yahya-tamur/blinds/carrier/pcb/boards/v0.2.0/manufacturing/carrier_v0.2.0_assembly.stl

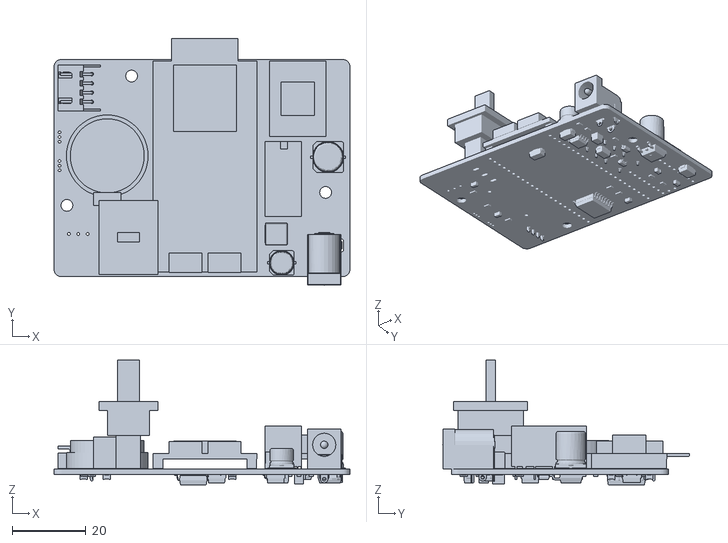
[picture p3: CAD file, 2026-11-02]
carrier/pcb/boards/v0.2.0/manufacturing/carrier_v0.2.0_assembly.stl
80.1 x 66.7 x 33.7
