yahya-tamur/blinds/carrier/pcb/boards/v0.2.0/carrier.kicad_pcb

## KiCad design carrier/pcb/boards/v0.2.0/carrier.kicad_pcb (2026-11-02)

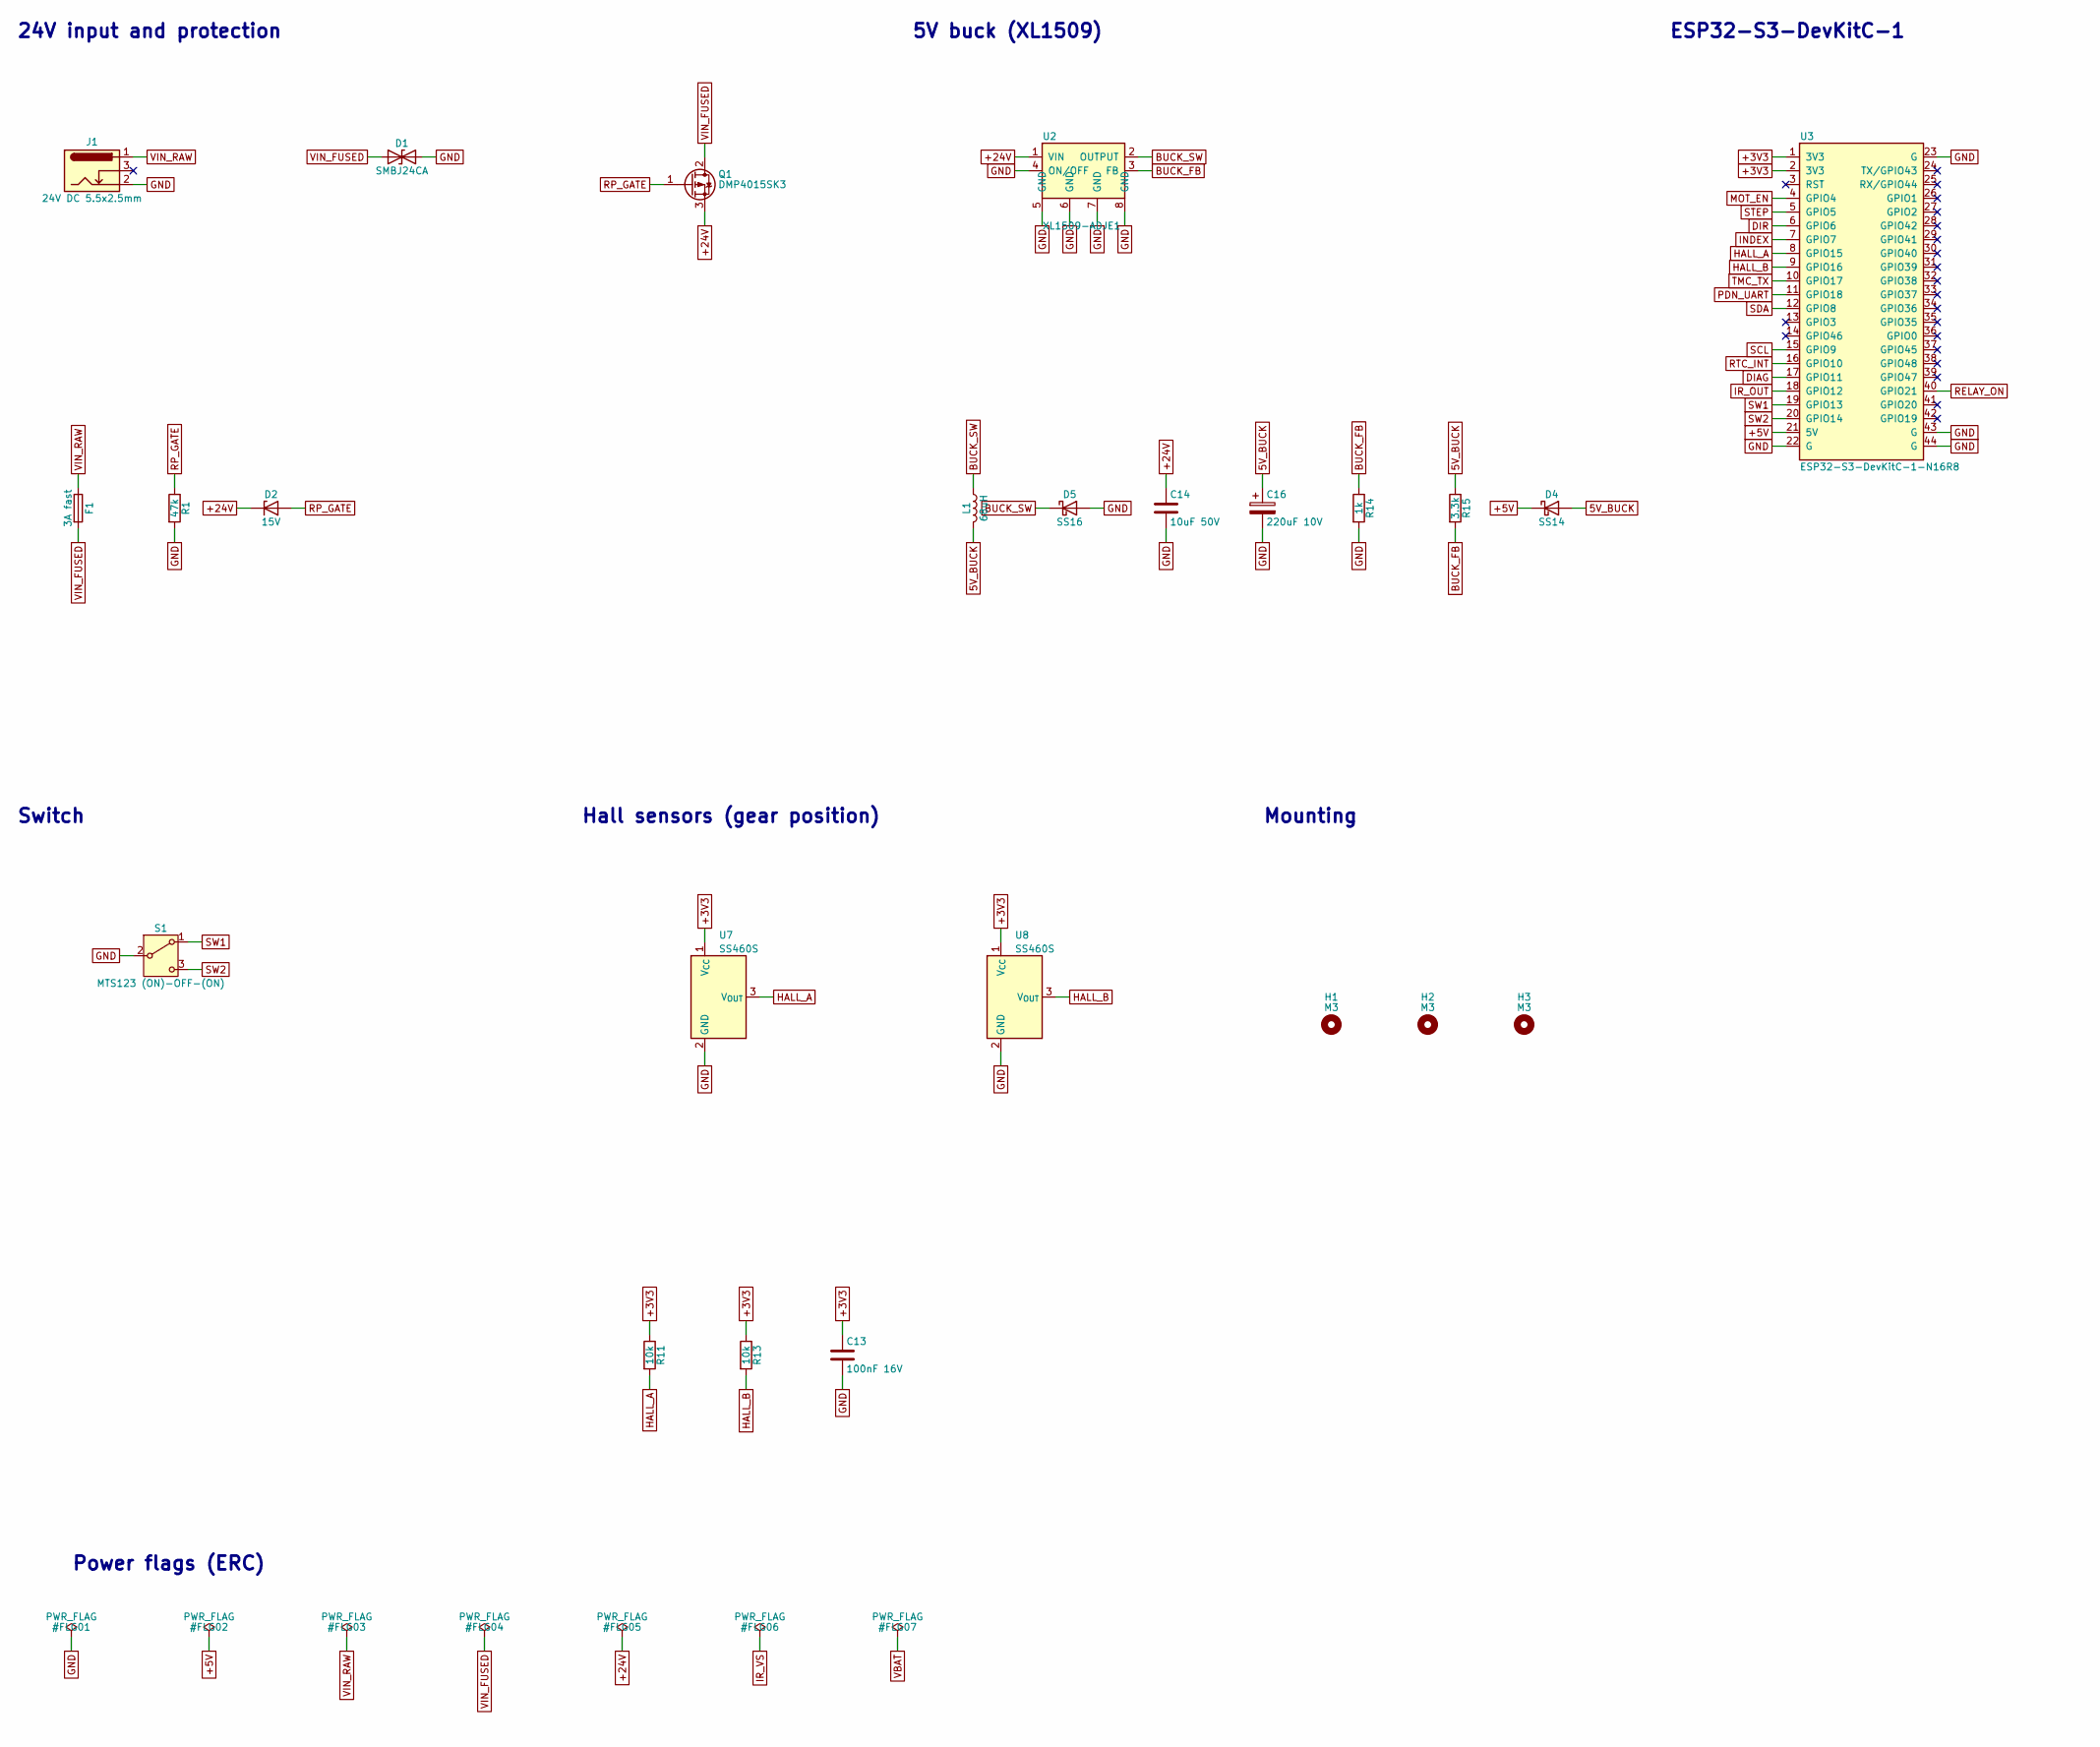
[picture p5: schematic carrier.kicad_sch, ESP32-S3 stepper controller - carrier v0.2.0, part in row 1, column 1]

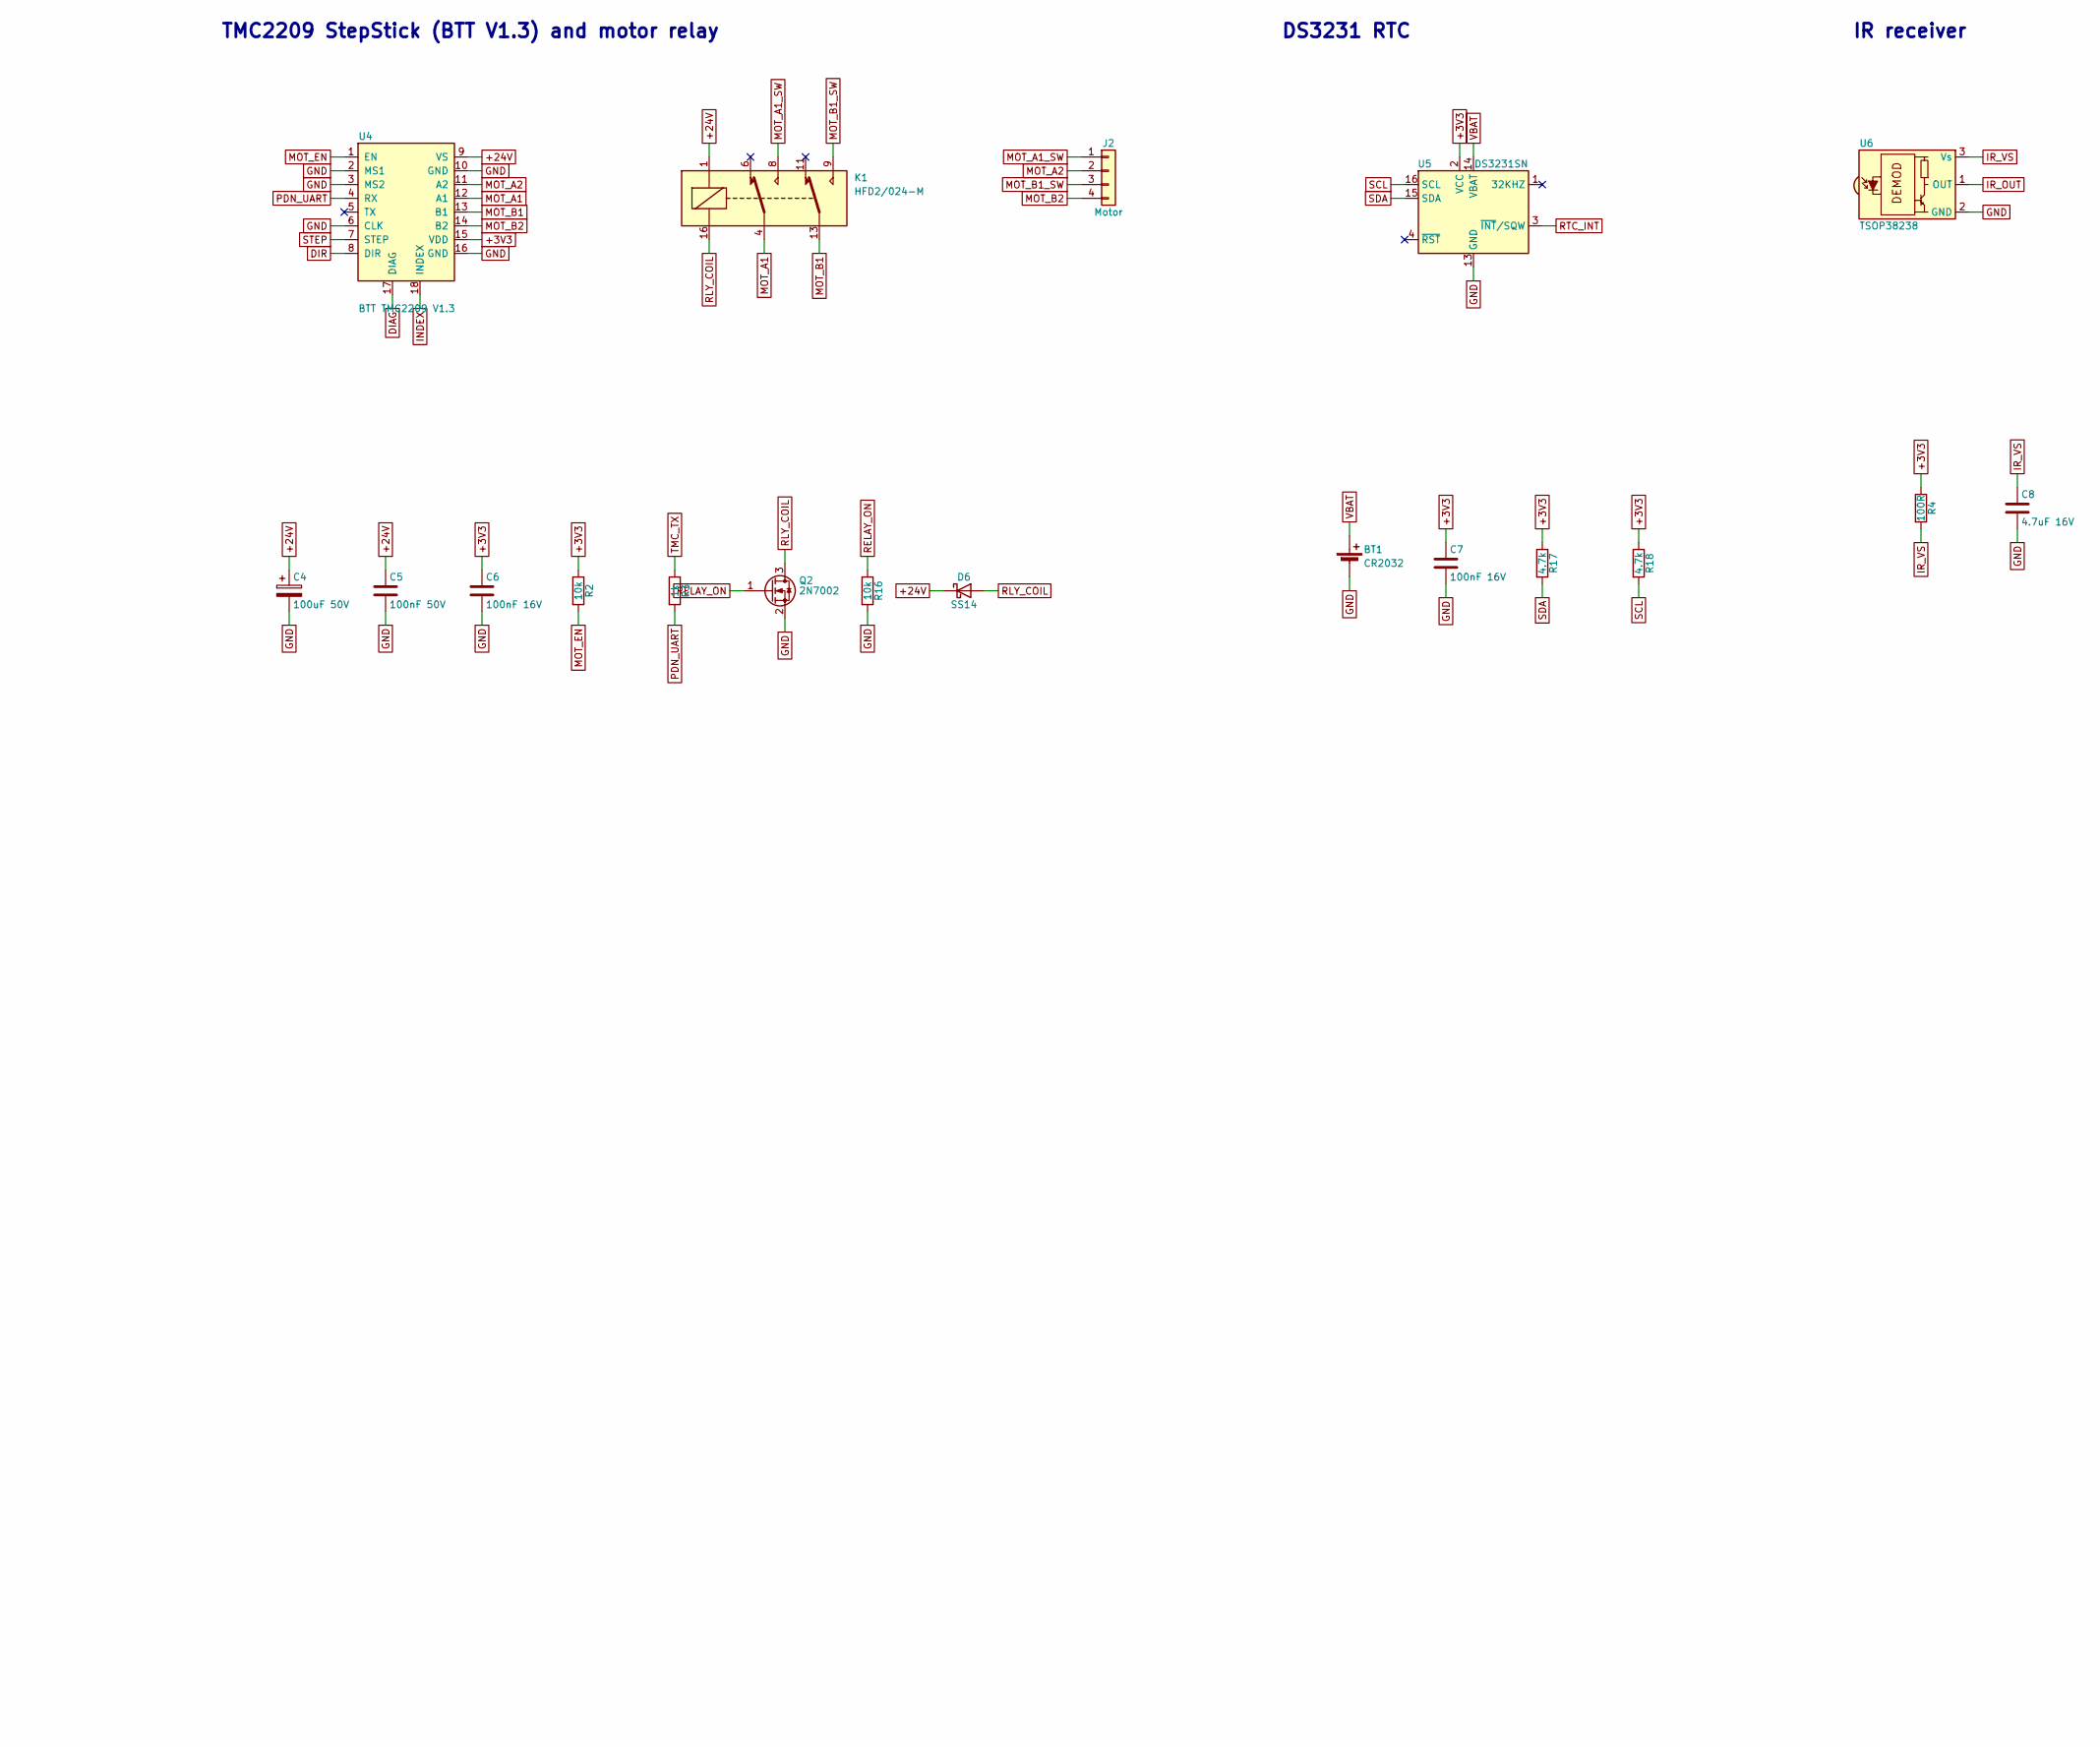
[picture p6: schematic carrier.kicad_sch, ESP32-S3 stepper controller - carrier v0.2.0, part in row 1, column 2]

Parts:
BT1: CR2032; BatteryHolder_MYOUNG_BS-02-A1AJ010; MPN BS-02-A1AJ010; LCSC C5239862
C4: 100uF 50V; CP_Elec_8x10; MPN EEE-FK1H101P; LCSC C178548
C5: 100nF 50V; C_0805_2012Metric; LCSC C49678
C6, C7, C13: 100nF 16V; C_0805_2012Metric; LCSC C49678
C8: 4.7uF 16V; C_0805_2012Metric; LCSC C1779
C14: 10uF 50V; C_1210_3225Metric; MPN CL32B106KBJNNNE; LCSC C138687
C16: 220uF 10V; CP_Elec_6.3x5.4; MPN FVH010ADA221M0654; LCSC C7469982
D1: SMBJ24CA; D_SMB; MPN SMBJ24CA; LCSC C83268
D2: 15V; D_SOD-123; MPN MMSZ5245B; LCSC C2126
D4, D6: SS14; D_SMA; MPN SS14; LCSC C2480
D5: SS16; D_SMA; MPN SS16; LCSC C2481
F1: 3A fast; Fuse_Littelfuse-NANO2-451_453; MPN 0453003.MR; LCSC C178991
H1, H2, H3: M3; MountingHole_3.2mm_M3
J1: 24V DC 5.5x2.5mm; BarrelJack_DC-005_2.5mm_Horizontal_EdgeMount; MPN DC-005-5A-2.5; LCSC C381115
J2: Motor; JST_XH_S4B-XH-A_1x04_P2.50mm_Horizontal; MPN S4B-XH-A; LCSC C157925
K1: HFD2/024-M; Relay_DPDT_Hongfa_HFD2; MPN HFD2/024-M; LCSC C18198081
L1: 68uH; L_Changjiang_FNR6045S; MPN FNR6045S680MT; LCSC C168091
Q1: DMP4015SK3; TO-252-2; MPN DMP4015SK3-13; LCSC C513222
Q2: 2N7002; SOT-23; MPN 2N7002; LCSC C8545
R1: 47k; R_0805_2012Metric; LCSC C17713
R2, R11, R13, R16: 10k; R_0805_2012Metric; LCSC C17414
R3, R14: 1k; R_0805_2012Metric; LCSC C17513
R4: 100R; R_0805_2012Metric; LCSC C17408
R15: 3.3k; R_0805_2012Metric; LCSC C26010
R17, R18: 4.7k; R_0805_2012Metric; LCSC C17673
S1: MTS123 (ON)-OFF-(ON); Switch_CAX_MTS123_D2; MPN CAX-MTS123-D2-BKJL; LCSC C55072606
U2: XL1509-ADJE1; SOIC-8_3.9x4.9mm_P1.27mm; MPN XL1509-ADJE1; LCSC C74192
U3: ESP32-S3-DevKitC-1-N16R8; ESP32-S3-DevKitC-1_Soldered; MPN ESP32-S3-DevKitC-1-N16R8
U4: BTT TMC2209 V1.3; StepStick_BTT_TMC2209_Soldered; MPN BIGTREETECH TMC2209 V1.3
U5: DS3231SN; SOIC-16W_7.5x10.3mm_P1.27mm; MPN DS3231SN#T&R; LCSC C9866
U6: TSOP38238; IR_Receiver_3Pin_LyingFlat; MPN TSOP38238; LCSC C141632
U7, U8: SS460S; TO-92S; MPN SS460S; LCSC C111925

Connections:
5V_BUCK: C16.1, D4.2 (A), L1.2, R15.1
+3V3: C6.1, C7.1, C13.1, R2.1, R4.1, R11.1, R13.1, R17.1, R18.1, U3.1 (3V3), U3.2 (3V3), U4.15 (VDD), U5.2 (VCC), U7.1 (V_{CC}), U8.1 (V_{CC})
+5V: D4.1 (K), U3.21 (5V)
+24V: C4.1, C5.1, C14.1, D2.1 (K), D6.1 (K), K1.1, Q1.3 (S), U2.1 (VIN), U4.9 (VS)
BUCK_FB: R14.1, R15.2, U2.3 (FB)
BUCK_SW: D5.1 (K), L1.1, U2.2 (OUTPUT)
DIAG: U3.17 (GPIO11), U4.17 (DIAG)
DIR: U3.6 (GPIO6), U4.8 (DIR)
GND: BT1.2 (-), C4.2, C5.2, C6.2, C7.2, C8.2, C13.2, C14.2, C16.2, D1.2 (A2), D5.2 (A), J1.2, Q2.2 (S), R1.2, R14.2, R16.2, S1.2 (B), U2.4 (ON/OFF), U2.5 (GND), U2.6 (GND), U2.7 (GND), U2.8 (GND), U3.22 (G), U3.23 (G), U3.43 (G), U3.44 (G), U4.2 (MS1), U4.3 (MS2), U4.6 (CLK), U4.10 (GND), U4.16 (GND), U5.5 (GND), U5.6 (GND), U5.7 (GND), U5.8 (GND), U5.9 (GND), U5.10 (GND), U5.11 (GND), U5.12 (GND), U5.13 (GND), U6.2 (GND), U7.2 (GND), U8.2 (GND)
HALL_A: R11.2, U3.8 (GPIO15), U7.3 (V_{OUT})
HALL_B: R13.2, U3.9 (GPIO16), U8.3 (V_{OUT})
INDEX: U3.7 (GPIO7), U4.18 (INDEX)
IR_OUT: U3.18 (GPIO12), U6.1 (OUT)
IR_VS: C8.1, R4.2, U6.3 (Vs)
MOT_A1: K1.4, U4.12 (A1)
MOT_A1_SW: J2.1, K1.8
MOT_A2: J2.2, U4.11 (A2)
MOT_B1: K1.13, U4.13 (B1)
MOT_B1_SW: J2.3, K1.9
MOT_B2: J2.4, U4.14 (B2)
MOT_EN: R2.2, U3.4 (GPIO4), U4.1 (EN)
PDN_UART: R3.2, U3.11 (GPIO18), U4.4 (RX)
RELAY_ON: Q2.1 (G), R16.1, U3.40 (GPIO21)
RLY_COIL: D6.2 (A), K1.16, Q2.3 (D)
RP_GATE: D2.2 (A), Q1.1 (G), R1.1
RTC_INT: U3.16 (GPIO10), U5.3 (~INT/SQW)
SCL: R18.2, U3.15 (GPIO9), U5.16 (SCL)
SDA: R17.2, U3.12 (GPIO8), U5.15 (SDA)
STEP: U3.5 (GPIO5), U4.7 (STEP)
SW1: S1.1 (A), U3.19 (GPIO13)
SW2: S1.3 (C), U3.20 (GPIO14)
TMC_TX: R3.1, U3.10 (GPIO17)
VBAT: BT1.1 (+), U5.14 (VBAT)
VIN_FUSED: D1.1 (A1), F1.2, Q1.2 (D)
VIN_RAW: F1.1, J1.1

Notes on the sheet:
24V input and protection
5V buck (XL1509)
ESP32-S3-DevKitC-1
TMC2209 StepStick (BTT V1.3) and motor relay
DS3231 RTC
IR receiver
Switch
Hall sensors (gear position)
Mounting
Power flags (ERC)

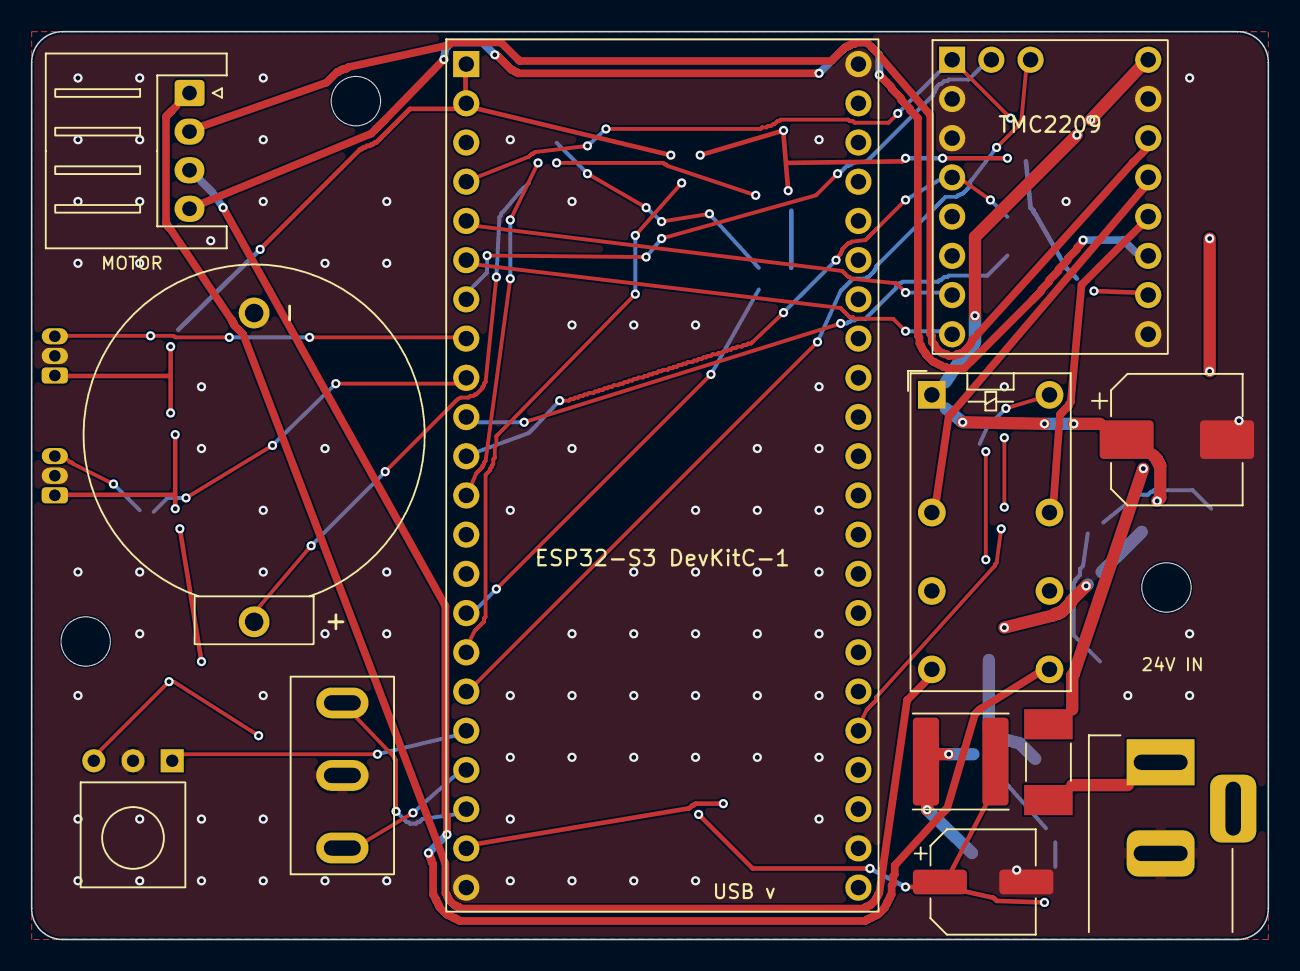
[picture p7: board carrier.kicad_pcb from above]

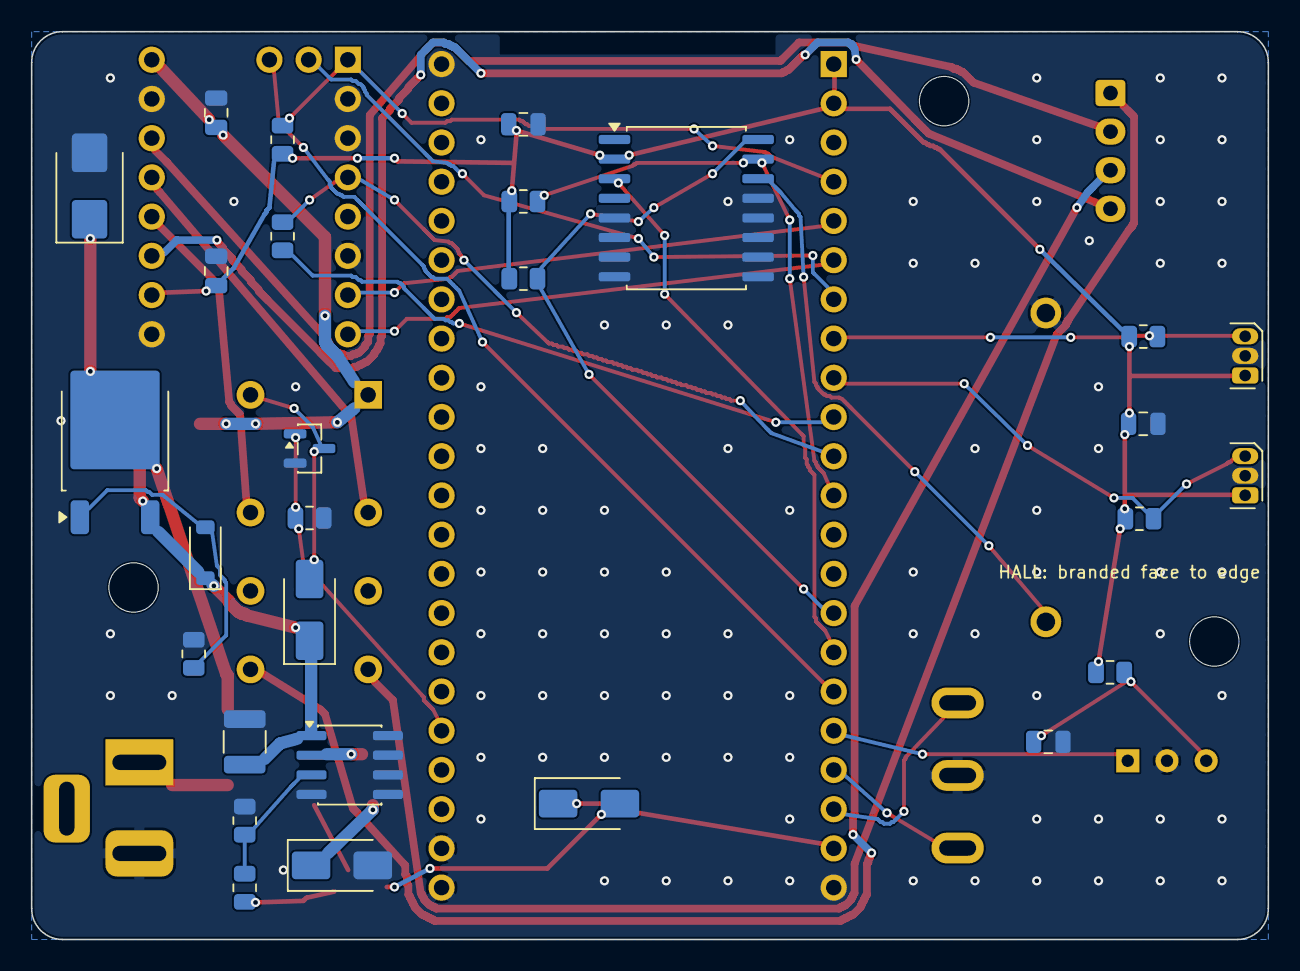
[picture p8: board carrier.kicad_pcb from below]

Board: 2 copper layers, 80.1 x 58.8 mm, 43 parts (28 on the bottom side), 35 nets.
