yahya-tamur/blinds/carrier/firmware/main/secrets.example.h

// Wi-Fi network the controller joins. Copy this file to secrets.h and fill in your network.
// secrets.h is kept out of git so the password isn't committed. Without it, Wi-Fi stays off.
#pragma once

#define SECRET_SSID "your-network-name"
#define SECRET_PASS "your-password"
