yahya-tamur/blinds/arduino/arduino_secrets.example.h

// WiFi network the controller joins. Copy this file to arduino_secrets.h and fill in
// your network. arduino_secrets.h is kept out of git so the password isn't committed.

#define SECRET_SSID "your-network-name"
#define SECRET_PASS "your-password"
