yahya-tamur/blinds/(commit log)

2026-10-25 Arduino blinds controller
    UNO R4 WiFi sketch that drives a TMC2209 stepper (1/16 microstepping,
    step pulses from a hardware timer) to raise and lower blinds:
    - Hold-to-move switch buttons; remote and web up/down start a 40 s run
    that the switch, the remote's cancel button or the web Stop button
    can cancel.
    - DS3231 clock synced from the internet at boot, with US Pacific
    daylight saving applied automatically.
    - Web page served by the board: live clock, up/down, alarm list
    (stored in EEPROM, shown soonest first) and a moving page with a
    countdown. Pages are built from web/ by build_pages.py into pages.h;
    web/mock_server.py previews them without the board.
    - Serial log mirrored to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
2026-10-29 Add ESP32-S3 carrier firmware and rev 2 soldering guide
    Firmware (ESP-IDF v6.1, C) for the module carrier board: a port of the
    Arduino blinds controller with the switch, NEC IR remote, web page with
    a JSON API, NVS alarms, DS3231 + SNTP time and ramped TMC2209 motor
    runs, plus hardware bring-up tests. Docs: the rev 2 soldering checklist
    page and a small server for it. PCB files, CLAUDE.md files, sdkconfig
    and Wi-Fi secrets are git-ignored.
2026-10-29 Publish the soldering guide on GitHub Pages
    A workflow builds carrier/docs into a small site (landing page at /,
    soldering checklist at /soldering-guide/) and deploys it to Pages on
    every push that changes carrier/docs.
2026-10-29 Make the soldering guide a standalone HTML page
    The guide now carries its own doctype and head, so it opens anywhere.
    serve.py is a plain previewer that answers at the public addresses
    (/ and /soldering-guide/), and build_site.py only copies files into
    the Pages layout.
2026-10-29 Lay out carrier/docs like the site; dark pages; badge cover fix
    carrier/docs now mirrors the published site (index.html, favicon.svg,
    soldering-guide/), so the Pages workflow uploads it as-is and the
    build and serve scripts are gone; preview with python3 -m http.server.
    Both pages are always dark, and finished parts in the guide now cover
    their whole number badge.
2026-10-29 Track the enclosure STLs (carrier rev 2 board and assembly)
    [carrier_rev2_assembly.stl, carrier_rev2_board.stl]
2026-10-29 Arduino: ramped motor runs with planned stops and back-off, toggle switch, larger program stack
    Runs speed up, cruise and slow down, with planned stops and a quarter-turn
    back-off; the driver is configured over UART before each run. The switch is
    an up/off/down toggle that starts and cancels runs. The program runs on its
    own stack. The moving page gains a live clock and Stop lands where Up/Down were.
2026-10-29 Soldering guide: drop the 1x20-at-the-top note for the DevKit headers
2026-10-30 Add the SS460S Hall sensor STL for designing the sensor mount
    [ss460s.stl]
2026-11-02 Add the v0.2.0 carrier KiCad project (schematic, board, project)
    The board file embeds every footprint, so these three files open in KiCad on
    their own and plot the same Gerbers and drill files that were ordered. The old
    J4-design soldering guide is also git-ignored here, to be deleted later.
    [carrier.kicad_pcb, carrier.kicad_sch]
2026-11-02 Firmware for carrier v0.2.0, bring-up test, v0.2.0 soldering guide
    Firmware:
    - Momentary (ON)-OFF-(ON) switch: a press posts one command; pushing against
    a run's direction stops it, the same way does nothing.
    - Every command is ignored while a run is ending (slowing to its stop,
    braking, pause, back-off).
    - Motor relay on GPIO21, switched only while EN is high.
    - Internal pull-ups for the switch, IR receiver and DS3231 SQW (v0.2.0 has
    no board pull-ups there).
    - Tests moved to main/tests/. New test_bringup checks a newly built board
    part by part and ends with a pass/fail list. New Hall and Hall+motor tests.
    The switches and RTC tests are removed; the IR, motor and Hall files keep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
    [app.c, app_config.h, board.h, bringup.c, clock.c, hall.c, inputs.h, ir.c]
2026-11-02 Untrack the enclosure STLs (v0.1.0 board models and the SS460S model); they stay local
    [carrier_rev2_assembly.stl, carrier_rev2_board.stl, ss460s.stl]
2026-11-02 Soldering guide v0.2.0: power checks as checklist steps, with plug-in, unplug and troubleshooting notes
2026-11-02 Soldering guide and bring-up test fixes
    Guide: unpowered relay check (spin the motor, the DevKit LEDs stay off) and
    a coin cell note at the end; the 3.3 V check lists only parts already
    fitted; reworded power check intro.
    Bring-up test: the relay-off open-load step is dropped (the guide's spin
    check covers it), no extra relay click; detects if pushing the switch up
    closes SW2 and says to swap SWITCH_UP_PIN/SWITCH_DOWN_PIN; clearer IR
    message; points to the guide's power checks.
    [bringup.c]
2026-11-02 Track the v0.2.0 assembly STL in manufacturing/ for designing the enclosure
    [carrier_v0.2.0_assembly.stl]
2026-11-07 Keep setup-specific firmware tests local; only the bring-up test stays tracked
    - Move test_stallguard, test_spreadcycle and test_hall_motor out of the repository into
    firmware/local/tests/ (git-ignored). CMakeLists builds any tests found there, and tests.h
    includes local/tests/local_tests.h when it exists, so a fresh clone builds without them.
    - Hall gear: 6 alternating magnets, 12 counts per turn (HALL_COUNTS_PER_REV 12).
    - board.h: the motor is now the YEJMKJ 60 mm NEMA 17 (2.3 A, 1.5 ohm, 2.8 mH, 84 Ncm).
    - main.c runs test_bringup, for the v0.2.0 boards.
